phtdacosta/morris-robot-project/res/arduino2.jpg

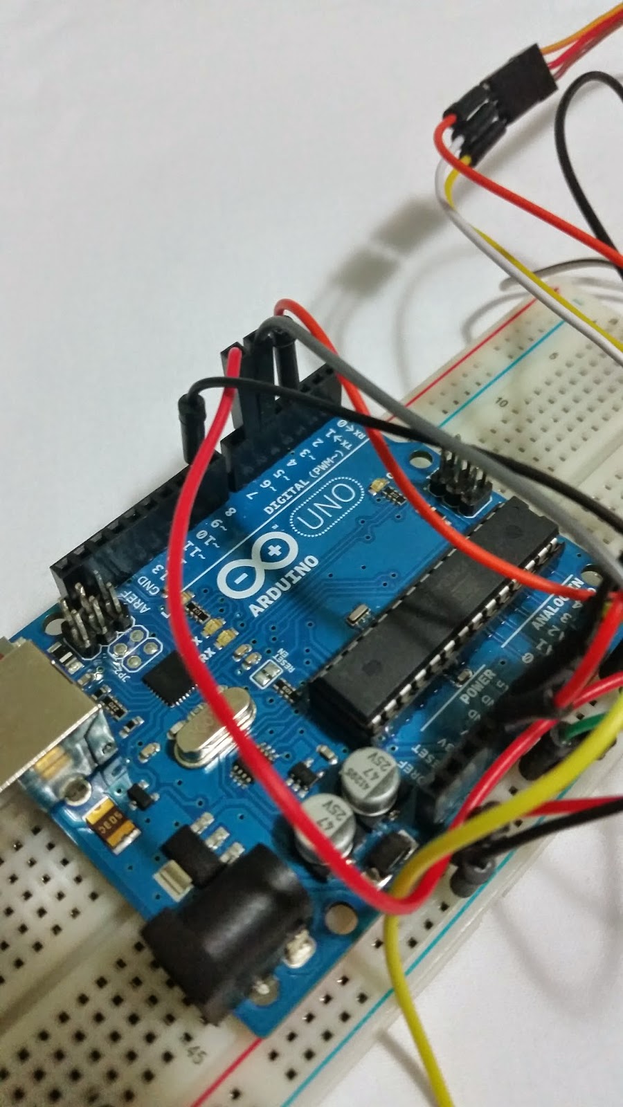
res/arduino2.jpg
