phtdacosta/morris-robot-project/res/arduino.jpg

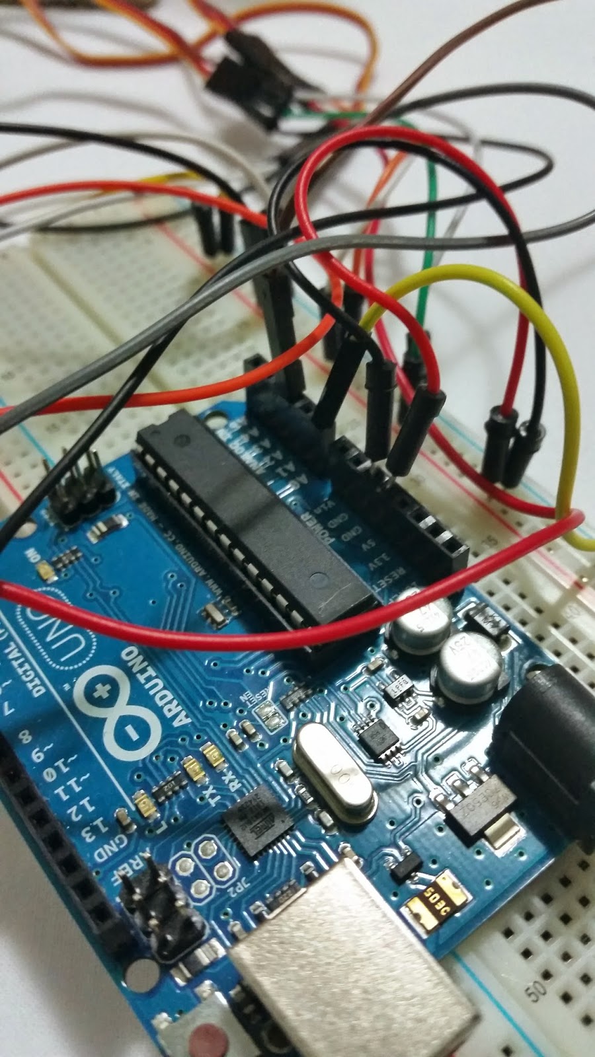
res/arduino.jpg
