phtdacosta/morris-robot-project/res/ldr2.jpg

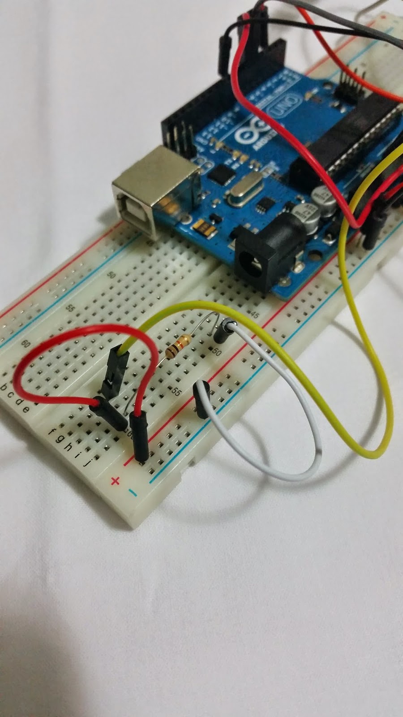
res/ldr2.jpg
