phtdacosta/morris-robot-project/res/ldr.jpg

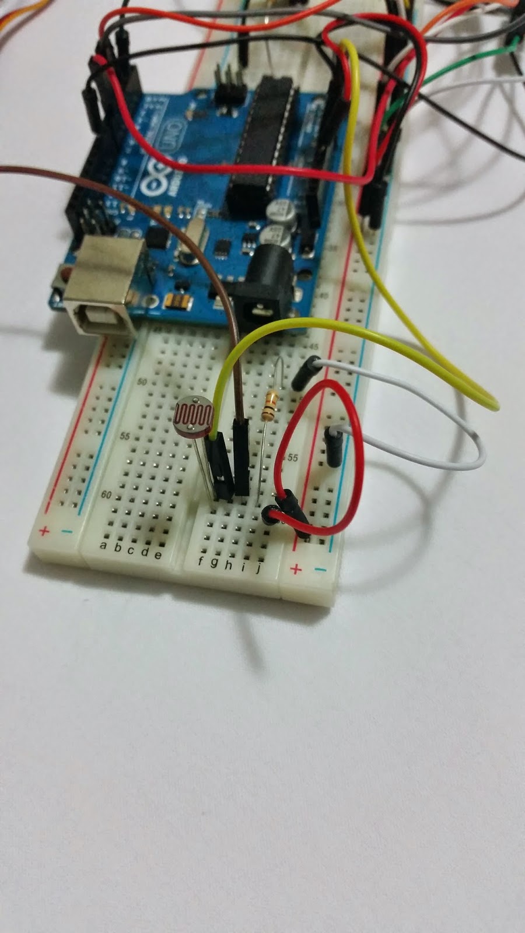
res/ldr.jpg
