phtdacosta/morris-robot-project/res/leftside.jpg

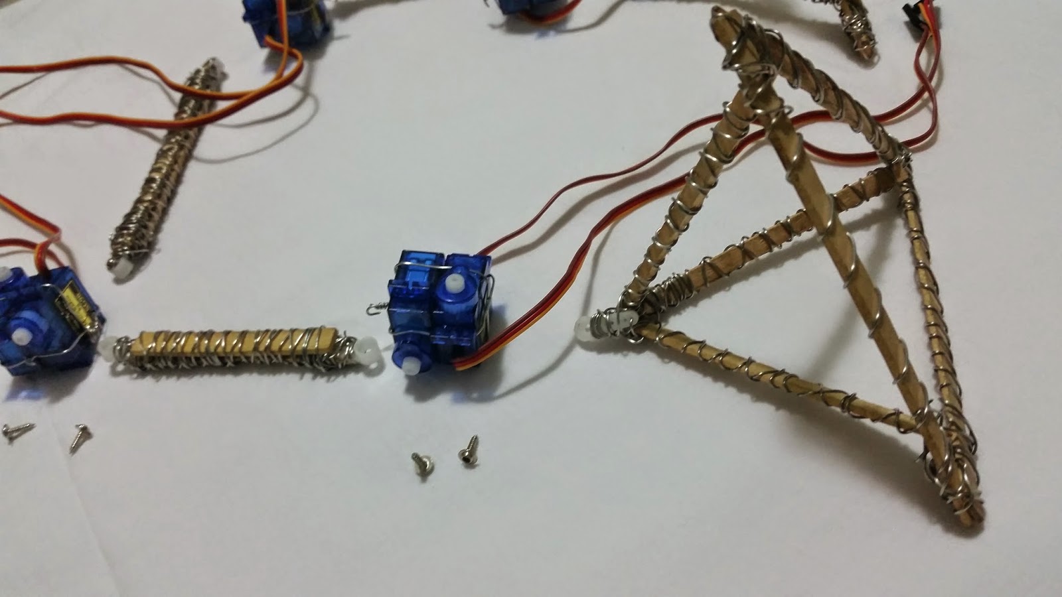
res/leftside.jpg
