phtdacosta/morris-robot-project/res/pinout2.jpg

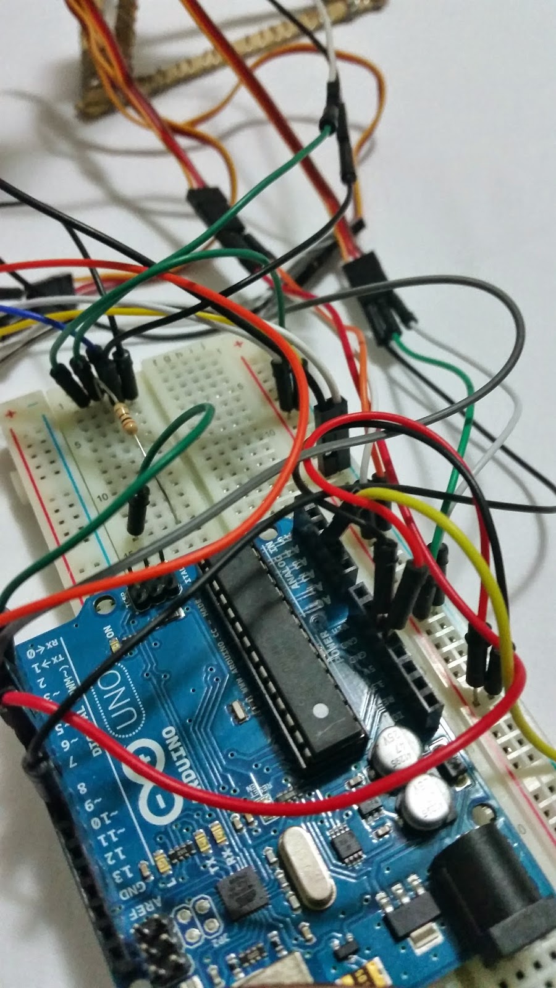
res/pinout2.jpg
