phtdacosta/morris-robot-project/res/pinout3.jpg

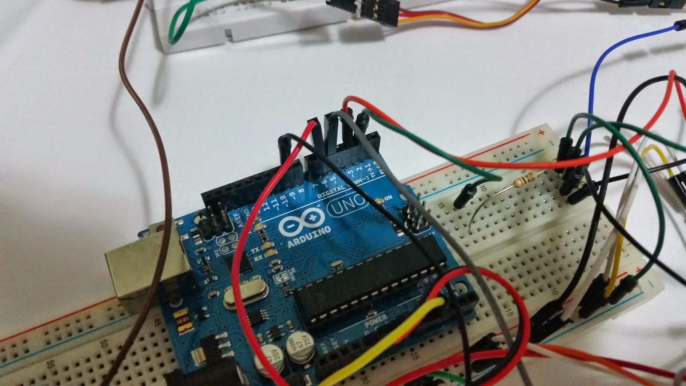
res/pinout3.jpg
