phtdacosta/morris-robot-project/res/pinout4.jpg

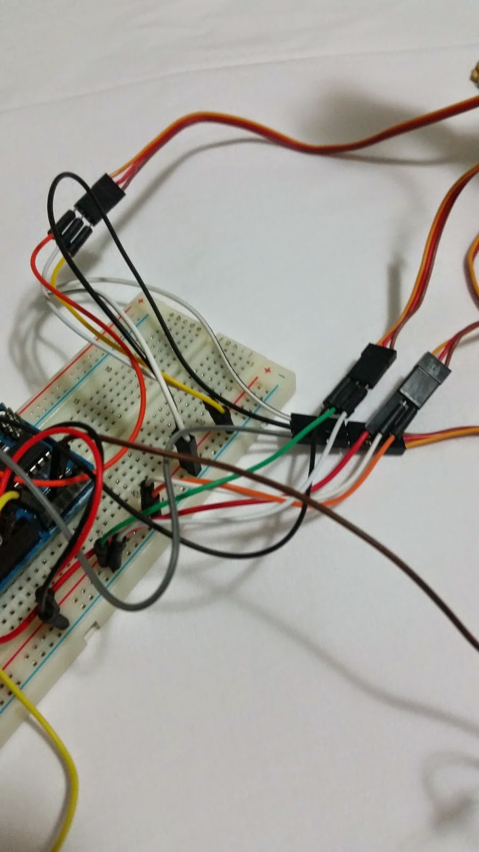
res/pinout4.jpg
