phtdacosta/morris-robot-project/res/pinout.jpg

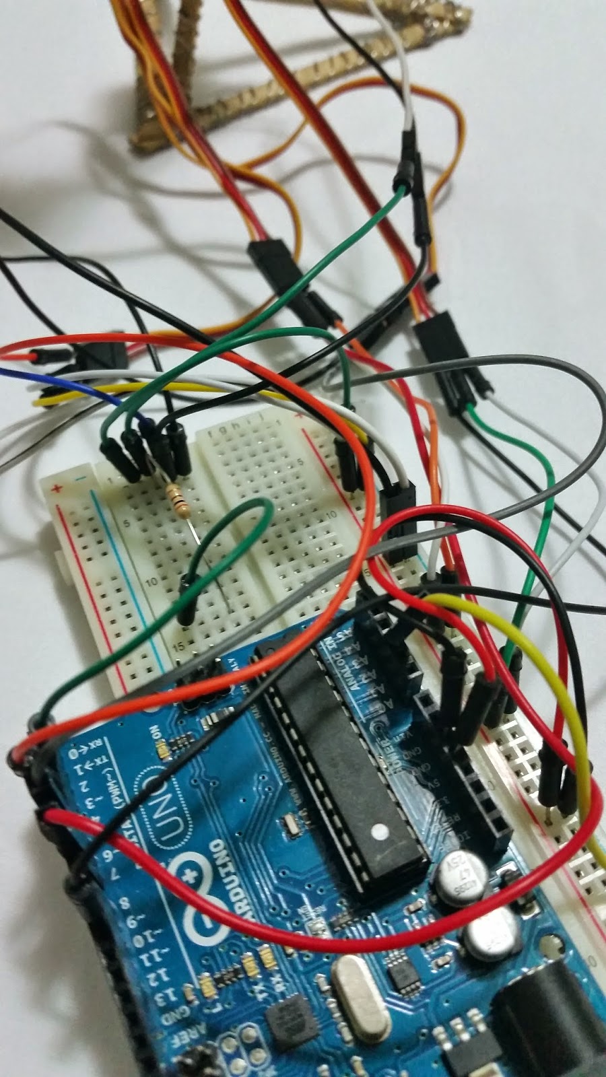
res/pinout.jpg
