phtdacosta/morris-robot-project/res/rightside.jpg

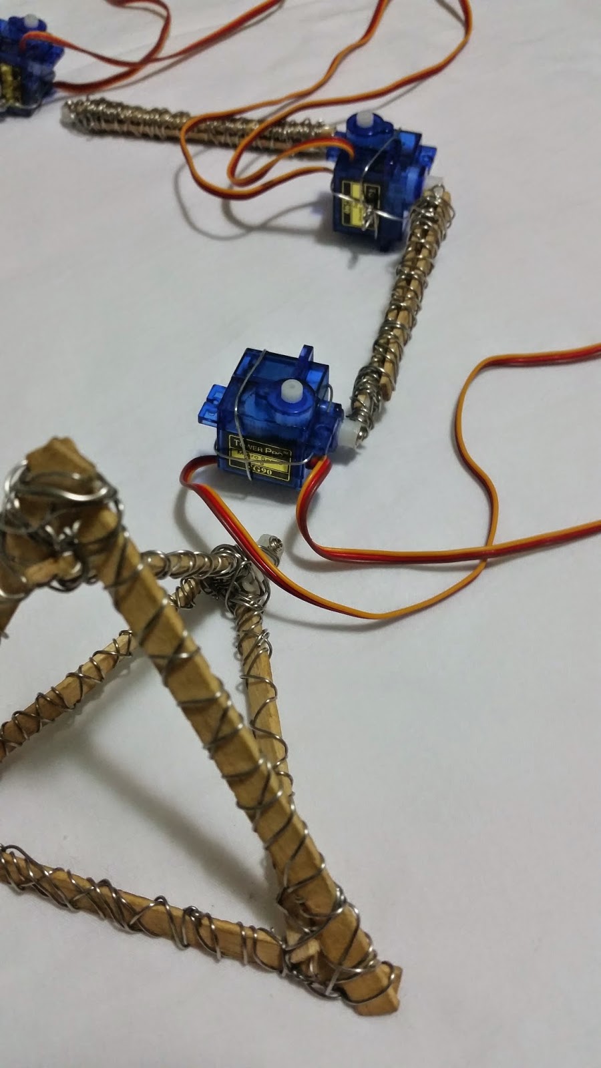
res/rightside.jpg
